IowaDave/Thermistors/images/teamwavelength-log-graph.png

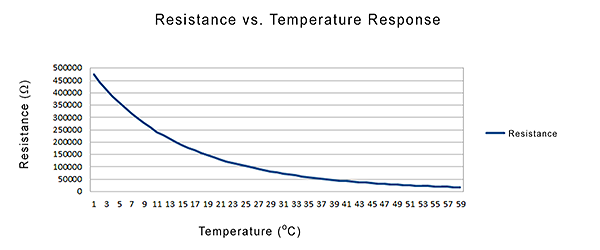
images/teamwavelength-log-graph.png
