IowaDave/Thermistors/Thermistor_LCD/Thermistor_LCD.ino

/*
 * thermistor-example-1.ino
 * Obtain an accurate temperature from a thermistor
 *
 * Copyright (c) 2023 David G Sparks
 *
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
 * This code was written for and tested on 
 * an Arduino Nano development board based on the
 * ATmega328P microcontroller..
 */

// LCD library includes
#include <Wire.h> 
#include <LiquidCrystal_I2C.h>
LiquidCrystal_I2C lcd(0x27,16,2);  // set the LCD address to 0x27 for a 16 chars and 2 line display

// Nano accepts analog input on pin A7.
// Modify as project requires for other boards.
#define ANALOG_INPUT 7

/*
 * 10 bits for older AVR-based MPUs and ESP8266
 * 12 bits for ESP32 and the new Arduino Uno R4
 * 12 bits also for the new AVR Dx series of MPUs
 */
#define ADC_RESOLUTION 10
// #define ADC_RESOLUTION 12
#define ADC_MAX ( pow(2,ADC_RESOLUTION) )

// Constants determined from the data sheet
// targeting range of -10 C to +30 C
#define REF_TEMP    263.15 // - 10 C + 273.15 degrees K
#define REF_RESIST  57670  // Ohms
#define BETA        3936 // 3936 for -10 to 30

// Fixed Resistor in series after the thermistor
#define R_FIXED     30000 // Ohms 

char vbgString[12];       // to format floating-point output

// function prototypes, defined below after loop()
double getTempK (void);
double getTempC (void);
double getTempF (void);
uint16_t readAnalogPin( uint8_t );

void setup() {
  lcd.init();                      // initialize the lcd 
  lcd.backlight();
  lcd.setCursor(0,0);
  lcd.print("OAT: ");

}

void loop() {
  lcd.setCursor(5,0);
  lcd.print(dtostrf(getTempF(), 6, 1, vbgString));
  lcd.write(0b11011111); // degrees symbol
  lcd.print("F");
  delay(14000);
}


uint16_t readAnalogPin( uint8_t pin)
{
  #define NUM_SAMPLES 10
  uint16_t adcAverage = 0;
  pinMode(pin, INPUT);
  for (int i = 0; i < NUM_SAMPLES; i++)
  {
    adcAverage += analogRead(pin);
    delay(5);
  }
  adcAverage /= NUM_SAMPLES;
  if (adcAverage == 0) adcAverage = 1;
  return adcAverage;
}

double getTempK ()
{
  double temp = // a scratchpad variable
  ( 
    (ADC_MAX / readAnalogPin ( ANALOG_INPUT ) )
     - 1)
    * R_FIXED; // begin with resistance in the thermistor
    
// Device error could be as much as 10% above or below.
// Adjust for a measured resistance 6% below actual.
   temp *= 1.07; // apply correction factor

  temp = // temperature derived from resistance
  ( 
    1 / 
    ( (1.0/REF_TEMP) - log(REF_RESIST/temp)/BETA )
  ); // temperature in degrees K
  return temp;
}

double getTempC () {
  return getTempK () - 273.15;
}

double getTempF () {
  return getTempC () * 1.8 + 32;
}
