IowaDave/Thermistors/(commit log)

2023-05-15 add calibration
2023-05-19 add attention to ADC resolution
2023-05-25 mention SAMD21-basesd Arduino boards
2023-06-05 conform ADC content to data sheet
2023-06-05 clarify discussion of ADC
